AntonEvmenenko/CLN-ClosedLoopNemaDriver/hardware/CLN17/V2.0/CLN17-V2.0.kicad_pcb

## KiCad design hardware/CLN17/V2.0/CLN17-V2.0.kicad_pcb (2025-08-09)

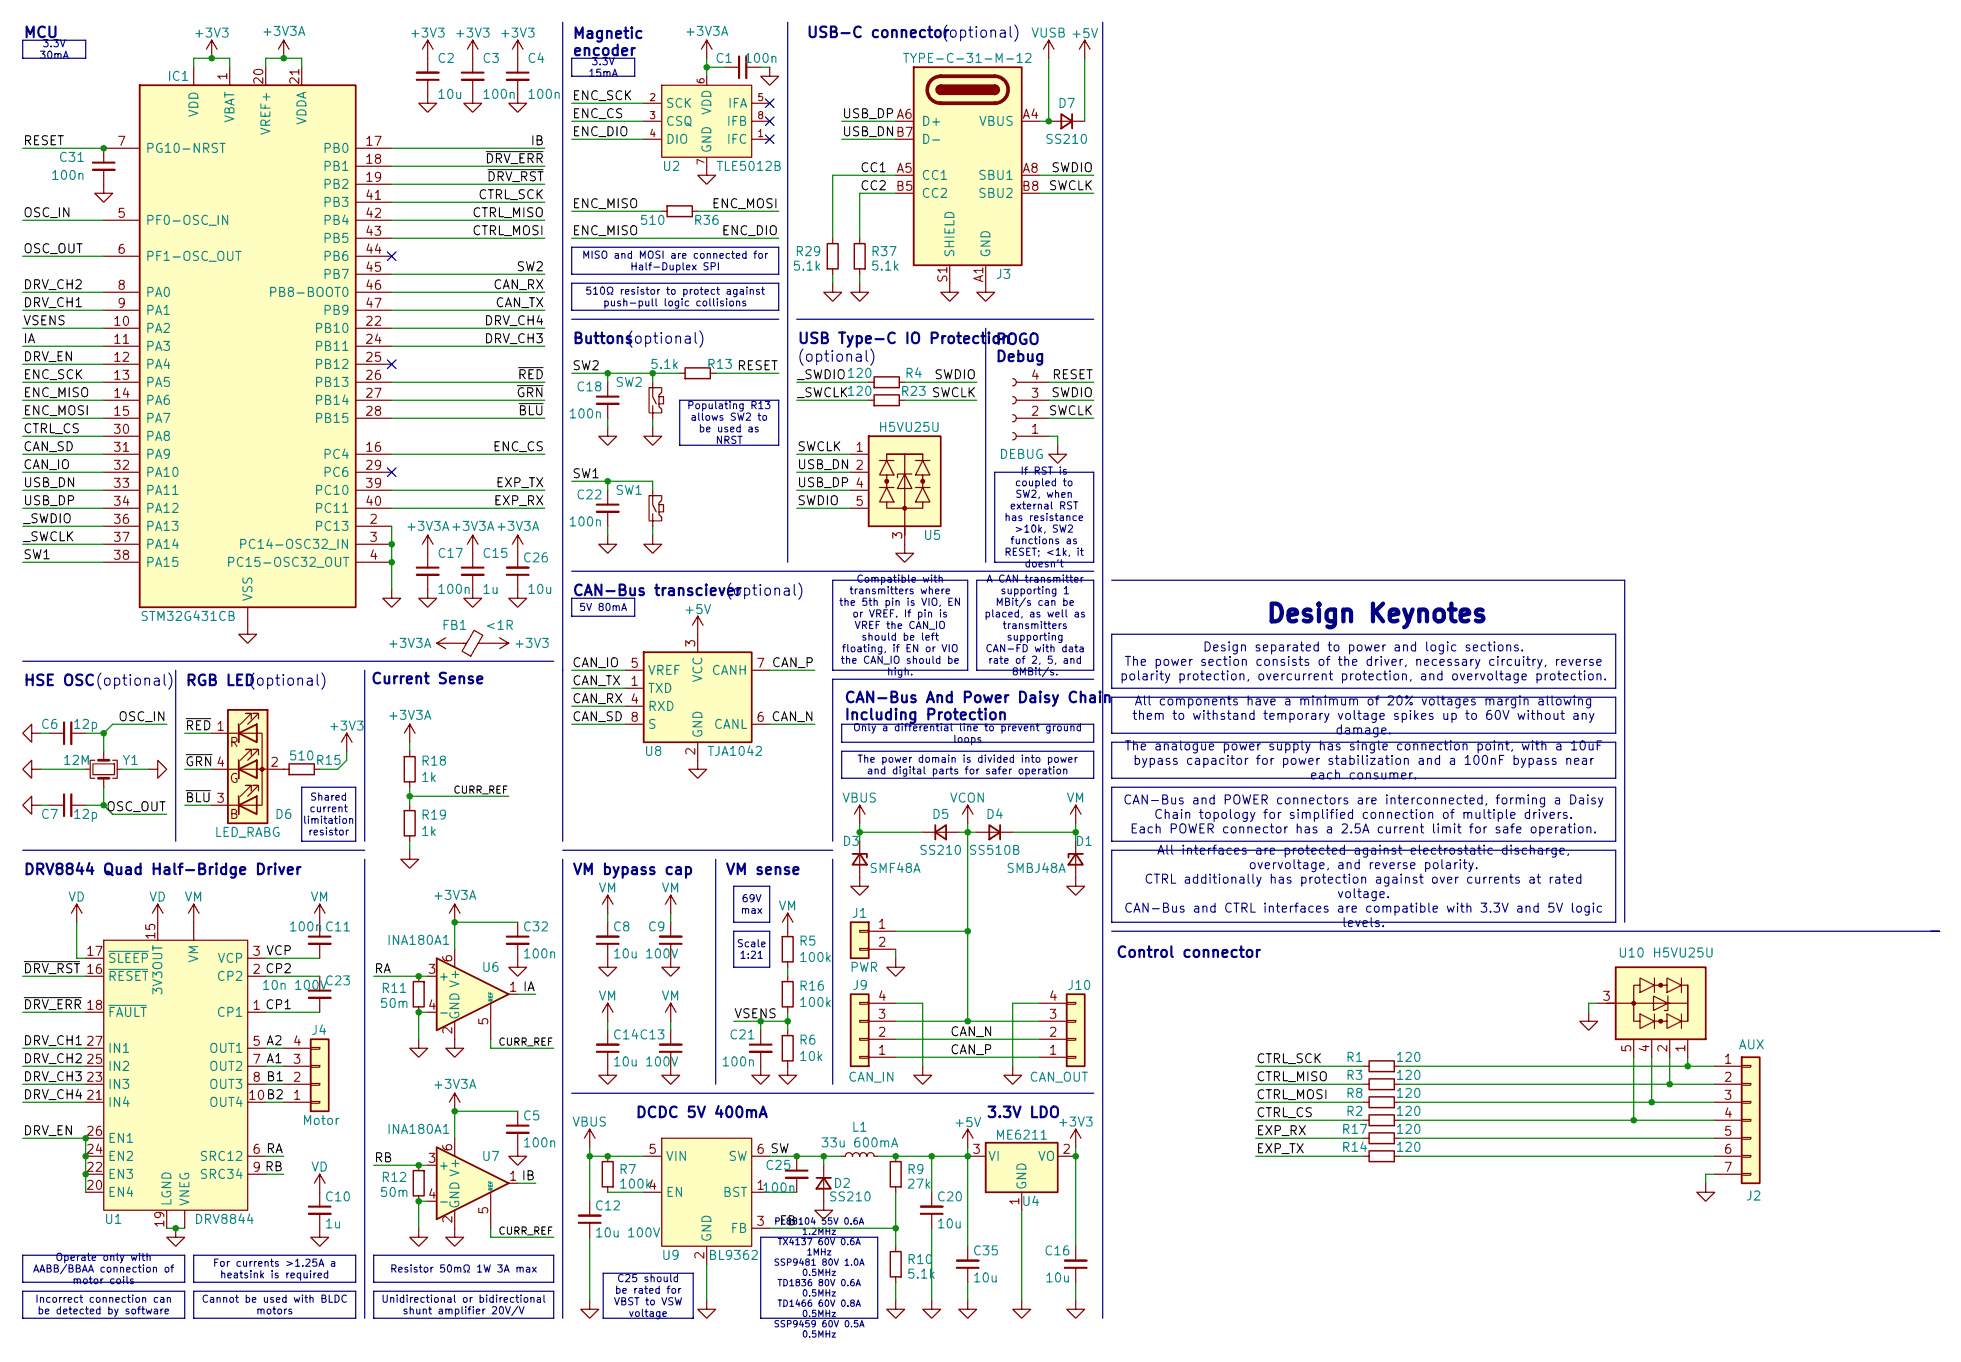
[picture p1: schematic CLN17-V2.0.kicad_sch, CLN17 V2 Closed-Loop Stepper Motor Driver]

Parts:
C1, C3, C4, C5, C11, C17, C18, C21, C22, C25, C31, C32: 100n; C0402; Part Type Basic; LCSC Part # C1525
C2, C16, C20, C26, C35: 10u; C0402; Part Type Basic; LCSC Part # C15525
C6, C7: 12p; C0402; Part Type Basic; LCSC Part # C1547
C8, C9, C12, C13, C14: 10u 100V; C1210; Part Type Extended; LCSC Part # C5156756
C10, C15: 1u; C0402; Part Type Basic; LCSC Part # C52923
C23: 10n 100V; C0402; Part Type Extended; LCSC Part # C527014
D1: SMBJ48A; D_SMB; Part Type Extended; LCSC Part # C353356
D2, D5, D7: SS210; D_SOD-123F; Part Type Extended; LCSC Part # C183475
D3: SMF48A; D_SOD-123F; Part Type Extended; LCSC Part # C353279
D4: SS510B; D_SMB; Part Type Extended; LCSC Part # C7420368
D6: LED_RABG; LED_RGB_0606; Part Type Extended; LCSC Part # C2874115
FB1: <1R; R0402; LCSC Part # C76883
IC1: STM32G431CB; QFN-48-1EP_7x7mm_P0.5mm_EP5.6x5.6mm; Part Type Extended; LCSC Part # C529356
J1: PWR; XH2.54 2P; Part Type Extended; LCSC Part # C2908611
J2: AUX; JST-S7B-ZR
J3: TYPE-C-31-M-12; USB-TYPE-C-31-M-12; Part Type Extended; LCSC Part # C2988369
J4: Motor; XH2.54 4P; Part Type Extended; LCSC Part # C5188444
J8: DEBUG; SWD; Part Type -----
J9: CAN_IN; PH2.0 4P; Part Type Extended; LCSC Part # C5188444
J10: CAN_OUT; PH2.0 4P; Part Type Extended; LCSC Part # C5188444
L1: 33u 600mA; CD32; Part Type Extended; LCSC Part # C492262
R1, R2, R3, R4, R8, R14, R17, R23: 120; R0402; Part Type Basic; LCSC Part # C25079
R5, R7, R16: 100k; R0402; Part Type Basic; LCSC Part # C25741
R6: 10k; R0402; Part Type Basic; LCSC Part # C25744
R9: 27k; R0402; Part Type Basic; LCSC Part # C25771
R10, R13, R29, R37: 5.1k; R0402; Part Type Basic; LCSC Part # C25941
R11, R12: 50m; R1206_Shunt; Part Type Extended; LCSC Part # C2924516
R15, R36: 510; R0402; Part Type Basic; LCSC Part # C25123
R18, R19: 1k; R0402; Part Type Basic; LCSC Part # C25741
SW1, SW2: SW_Push; SW_SPST_PTS810; Part Type Extended; LCSC Part # C2888430
U1: DRV8844; HTSSOP-28-1EP_4.4x9.7mm_P0.65mm_EP2.85x5.4mm; Part Type Extended; LCSC Part # C177807
U2: TLE5012B; SOIC-8_3.9x4.9mm_P1.27mm; Part Type Extended; LCSC Part # C123083
U4: ME6211; SOT-23-3; Part Type Basic; LCSC Part # C168807
U5, U10: H5VU25U; DFN-2510; Part Type Basic; LCSC Part # C7420374
U6, U7: INA180A1; SOT-23-6; Part Type Extended; LCSC Part # C122228
U8: TJA1042; HVSON-8-1EP_3x3mm_P0.65mm_EP1.6x2.4mm; Part Type Extended; LCSC Part # C131480
U9: BL9362; SOT-23-6; Part Type Extended; LCSC Part # C2909086
Y1: 12M; Crystal-3225-4P; Part Type Basic; LCSC Part # C9002

Connections:
+3V3: C2.2, C3.1, C4.1, C16.2, FB1.2, IC1.1 (VBAT), IC1.23 (VDD), IC1.35 (VDD), IC1.48 (VDD), R15.2, U4.2 (VO)
+3V3A: C1.1, C5.1, C15.1, C17.1, C26.2, C32.1, FB1.1, IC1.20 (VREF+), IC1.21 (VDDA), R18.1, U2.6 (VDD), U6.6 (V+), U7.6 (V+)
+5V: C20.2, C35.2, D7.1 (K), L1.2, R9.2, U4.3 (VI), U8.3 (VCC)
/A1: J4.3, U1.7 (OUT2)
/A2: J4.4, U1.5 (OUT1)
/B1: J4.2, U1.8 (OUT3)
/B2: J4.1, U1.10 (OUT4)
/CAN_IO: IC1.32 (PA10), U8.5 (VREF)
/CAN_N: J9.2, J10.2, U8.6 (CANL)
/CAN_P: J9.1, J10.1, U8.7 (CANH)
/CAN_RX: IC1.46 (PB8-BOOT0), U8.4 (RXD)
/CAN_SD: IC1.31 (PA9), U8.8 (S)
/CAN_TX: IC1.47 (PB9), U8.1 (TXD)
/CC1: J3.A5 (CC1), R29.2
/CC2: J3.B5 (CC2), R37.2
/CP1: C23.2, U1.1 (CP1)
/CP2: C23.1, U1.2 (CP2)
/CTRL_CS: IC1.30 (PA8), R2.2
/CTRL_MISO: IC1.42 (PB4), R3.2
/CTRL_MOSI: IC1.43 (PB5), R8.2
/CTRL_SCK: IC1.41 (PB3), R1.2
/CURR_REF: R18.2, R19.1, U6.5 (REF), U7.5 (REF)
/DRV_CH1: IC1.9 (PA1), U1.27 (IN1)
/DRV_CH2: IC1.8 (PA0), U1.25 (IN2)
/DRV_CH3: IC1.24 (PB11), U1.23 (IN3)
/DRV_CH4: IC1.22 (PB10), U1.21 (IN4)
/DRV_EN: IC1.12 (PA4), U1.20 (EN4), U1.22 (EN3), U1.24 (EN2), U1.26 (EN1)
/ENC_CS: IC1.16 (PC4), U2.3 (CSQ)
/ENC_DIO: IC1.14 (PA6), R36.1, U2.4 (DIO)
/ENC_MOSI: IC1.15 (PA7), R36.2
/ENC_SCK: IC1.13 (PA5), U2.2 (SCK)
/EXP_RX: IC1.40 (PC11), R17.2
/EXP_TX: IC1.39 (PC10), R14.2
/FB: R9.1, R10.2, U9.3 (FB)
/IA: IC1.11 (PA3), U6.1
/IB: IC1.17 (PB0), U7.1
/OSC_IN: C6.2, IC1.5 (PF0-OSC_IN), Y1.1
/OSC_OUT: C7.2, IC1.6 (PF1-OSC_OUT), Y1.3
/RA: R11.1, U1.6 (SRC12), U6.3 (+)
/RB: R12.1, U1.9 (SRC34), U7.3 (+)
/RESET: C31.1, IC1.7 (PG10-NRST), J8.4, R13.2
/SW: C25.1, D2.1 (K), L1.1, U9.6 (SW)
/SW1: C22.1, IC1.38 (PA15), SW1.1
/SW2: C18.1, IC1.45 (PB7), R13.1, SW2.1
/SWCLK: J3.B8 (SBU2), J8.2, R23.2, U5.1 (I/O1), U5.10
/SWDIO: J3.A8 (SBU1), J8.3, R4.2, U5.5 (I/O4), U5.6 (I/O4)
/USB_DN: IC1.33 (PA11), J3.A7 (D-), J3.B7 (D-), U5.2 (I/O2), U5.9 (I/O2)
/USB_DP: IC1.34 (PA12), J3.A6 (D+), J3.B6 (D+), U5.4 (I/O3), U5.7 (I/O3)
/VCP: C11.2, U1.3 (VCP)
/VSENS: C21.1, IC1.10 (PA2), R6.1, R16.2
/_SWCLK: IC1.37 (PA14), R23.1
/_SWDIO: IC1.36 (PA13), R4.1
/~BLU: D6.3 (BK), IC1.28 (PB15)
/~CTRL_5V: IC1.25 (PB12)
/~DRV_ERR: IC1.18 (PB1), U1.18 (~FAULT)
/~DRV_RST: IC1.19 (PB2), U1.16 (~RESET)
/~GRN: D6.4 (GK), IC1.27 (PB14)
/~RED: D6.1 (RK), IC1.26 (PB13)
GND: C1.2, C2.1, C3.2, C4.2, C5.2, C6.1, C7.1, C8.1, C9.1, C10.2, C12.1, C13.1, C14.1, C15.2, C16.1, C17.2, C18.2, C20.1, C21.2, C22.2, C26.1, C31.2, C32.2, C35.1, D1.2 (A), D2.2 (A), D3.2 (A), IC1.2 (PC13), IC1.3 (PC14-OSC32_IN), IC1.4 (PC15-OSC32_OUT), IC1.49 (VSS), J1.2, J2.7, J3.A1 (GND), J3.A12 (GND), J3.B1 (GND), J3.B12 (GND), J3.S1 (SHIELD), J8.1, J9.4, J10.4, R6.2, R10.1, R11.2, R12.2, R19.2, R29.1, R37.1, SW1.2, SW2.2, U1.14 (VNEG), U1.19 (LGND), U1.28 (VNEG), U1.29 (VNEG), U2.7 (GND), U4.1 (GND), U5.3 (GND), U5.8 (GND), U6.2 (GND), U6.4 (-), U7.2 (GND), U7.4 (-), U8.2 (GND), U8.9 (GND), U9.2 (GND), U10.3 (GND), U10.8 (GND), Y1.2, Y1.4
unnamed: D6.2 (A), R15.1
unnamed: J2.1, R1.1, U10.1 (I/O1), U10.10
unnamed: J2.2, R3.1, U10.2 (I/O2), U10.9 (I/O2)
unnamed: J2.3, R8.1, U10.4 (I/O3), U10.7 (I/O3)
unnamed: J2.4, R2.1, U10.5 (I/O4), U10.6 (I/O4)
unnamed: J2.5, R17.1
unnamed: J2.6, R14.1
unnamed: R5.2, R16.1
unnamed: C25.2, U9.1 (BST)
unnamed: R7.1, U9.4 (EN)
VBUS: C12.2, D3.1 (K), D5.1 (K), R7.2, U9.5 (VIN)
VCON: D4.2 (A), D5.2 (A), J1.1, J9.3, J10.3
VD: C10.1, U1.15 (3V3OUT), U1.17 (~SLEEP)
VM: C8.2, C9.2, C11.1, C13.2, C14.2, D1.1 (K), D4.1 (K), R5.1, U1.4 (VM), U1.11 (VM)
VUSB: D7.2 (A), J3.A4 (VBUS), J3.A9 (VBUS), J3.B4 (VBUS), J3.B9 (VBUS)

Notes on the sheet:
Operate only with AABB/BBAA connection of motor coils
Cannot be used with BLDC motors
CAN-Bus and POWER connectors are interconnected, forming a Daisy Chain topology for simplified connection of multiple drivers. Each POWER connector has a 2.5A current limit for safe operation.
Only a differential line to prevent ground loops
3.3V 30mA
A CAN transmitter supporting 1 MBit/s can be placed, as well as transmitters supporting CAN-FD with data rate of 2, 5, and 8MBit/s.
If RST is coupled to SW2, when external RST has resistance >10k, SW2 functions as RESET; <1k, it doesn't
The power domain is divided into power and digital parts for safer operation
Design separated to power and logic sections. The power section consists of the driver, necessary circuitry, reverse polarity protection, overcurrent protection, and overvoltage protection.
Shared current limitation resistor
C25 should be rated for VBST to VSW voltage
Unidirectional or bidirectional shunt amplifier 20V/V
Scale 1:21
Compatible with transmitters where the 5th pin is VIO, EN or VREF. If pin is VREF the CAN_IO should be left floating, if EN or VIO the CAN_IO should be high.
3.3V 15mA
Incorrect connection can be detected by software
PL88104 55V 0.6A 1.2MHz TX4137 60V 0.6A 1MHz SSP9481 80V 1.0A 0.5MHz TD1836 80V 0.6A 0.5MHz TD1466 60V 0.8A 0.5MHz SSP9459 60V 0.5A 0.5MHz
5V 80mA
Populating R13 allows SW2 to be used as NRST
All components have a minimum of 20% voltages margin allowing them to withstand temporary voltage spikes up to 60V without any damage.
Resistor 50mΩ 1W 3A max
69V max
All interfaces are protected against electrostatic discharge, overvoltage, and reverse polarity. CTRL additionally has protection against over currents at rated voltage. CAN-Bus and CTRL interfaces are compatible with 3.3V and 5V logic levels.
510Ω resistor to protect against push-pull logic collisions
The analogue power supply has single connection point, with a 10uF bypass capacitor for power stabilization and a 100nF bypass near each consumer.
For currents >1.25A a heatsink is required
MISO and MOSI are connected for Half-Duplex SPI
CAN-Bus And Power Daisy Chain Including Protection
(optional)
Magnetic encoder
MCU
CAN-Bus transciever
Control connector
DCDC 5V 400mA
VM bypass cap
USB-C connector
Current Sense
POGO Debug
DRV8844 Quad Half-Bridge Driver
Design Keynotes
Buttons
RGB LED
VM sense
HSE OSC
USB Type-C IO Protection
3.3V LDO

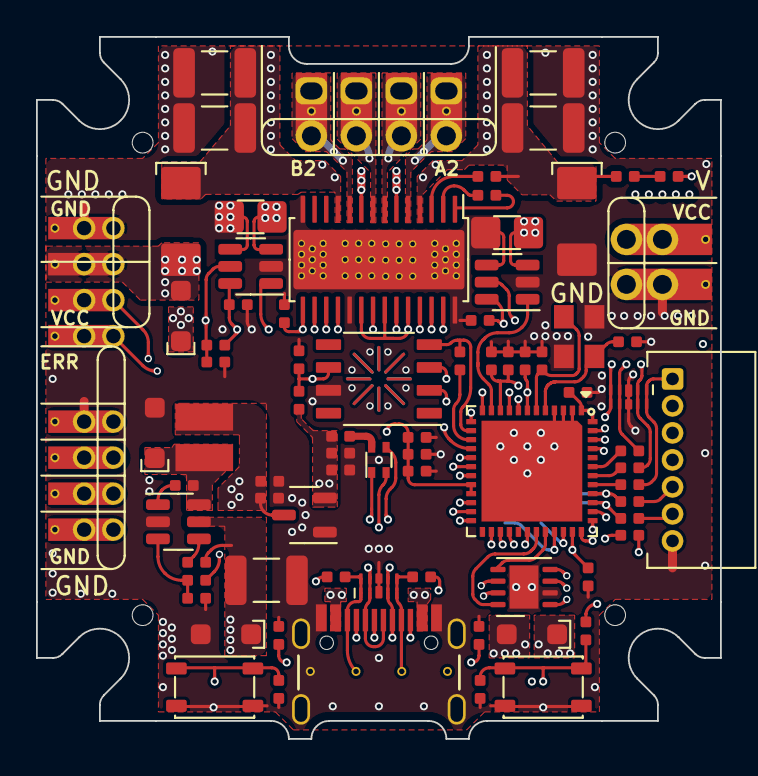
[picture p2: board CLN17-V2.0.kicad_pcb from above]

Board: 4 copper layers, 38.0 x 39.0 mm, 79 parts (1 on the bottom side), 73 nets.
