AntonEvmenenko/CLN-ClosedLoopNemaDriver/(commit log)

2025-07-31 [WIP] Before adding CAN connectors
    [CLN17-V2.0.kicad_pcb, CLN17-V2.0.kicad_sch]
2025-08-02 [WIP] Before rotating the CAN transceiver
    [CLN17-V2.0.kicad_pcb, CLN17-V2.0.kicad_sch]
2025-08-09 Almost done
    [CLN17-V2.0.kicad_pcb, CLN17-V2.0.kicad_sch]
2025-08-09 Minor PCB refactoring
    [CLN17-V2.0.kicad_pcb]
