AntonEvmenenko/CLN-ClosedLoopNemaDriver/(notices)

Notices in the files:
hardware/CLN17/V2.0/CLN17-V2.0.kicad_sch:
https://creativecommons.org/licenses/by-nc-sa/4.0
